FoxhoodDesigns/H-Pulse-Controller/KiCad/TRAIN_MK4.kicad_pcb

## KiCad design KiCad/TRAIN_MK4.kicad_pcb (2025-02-24)

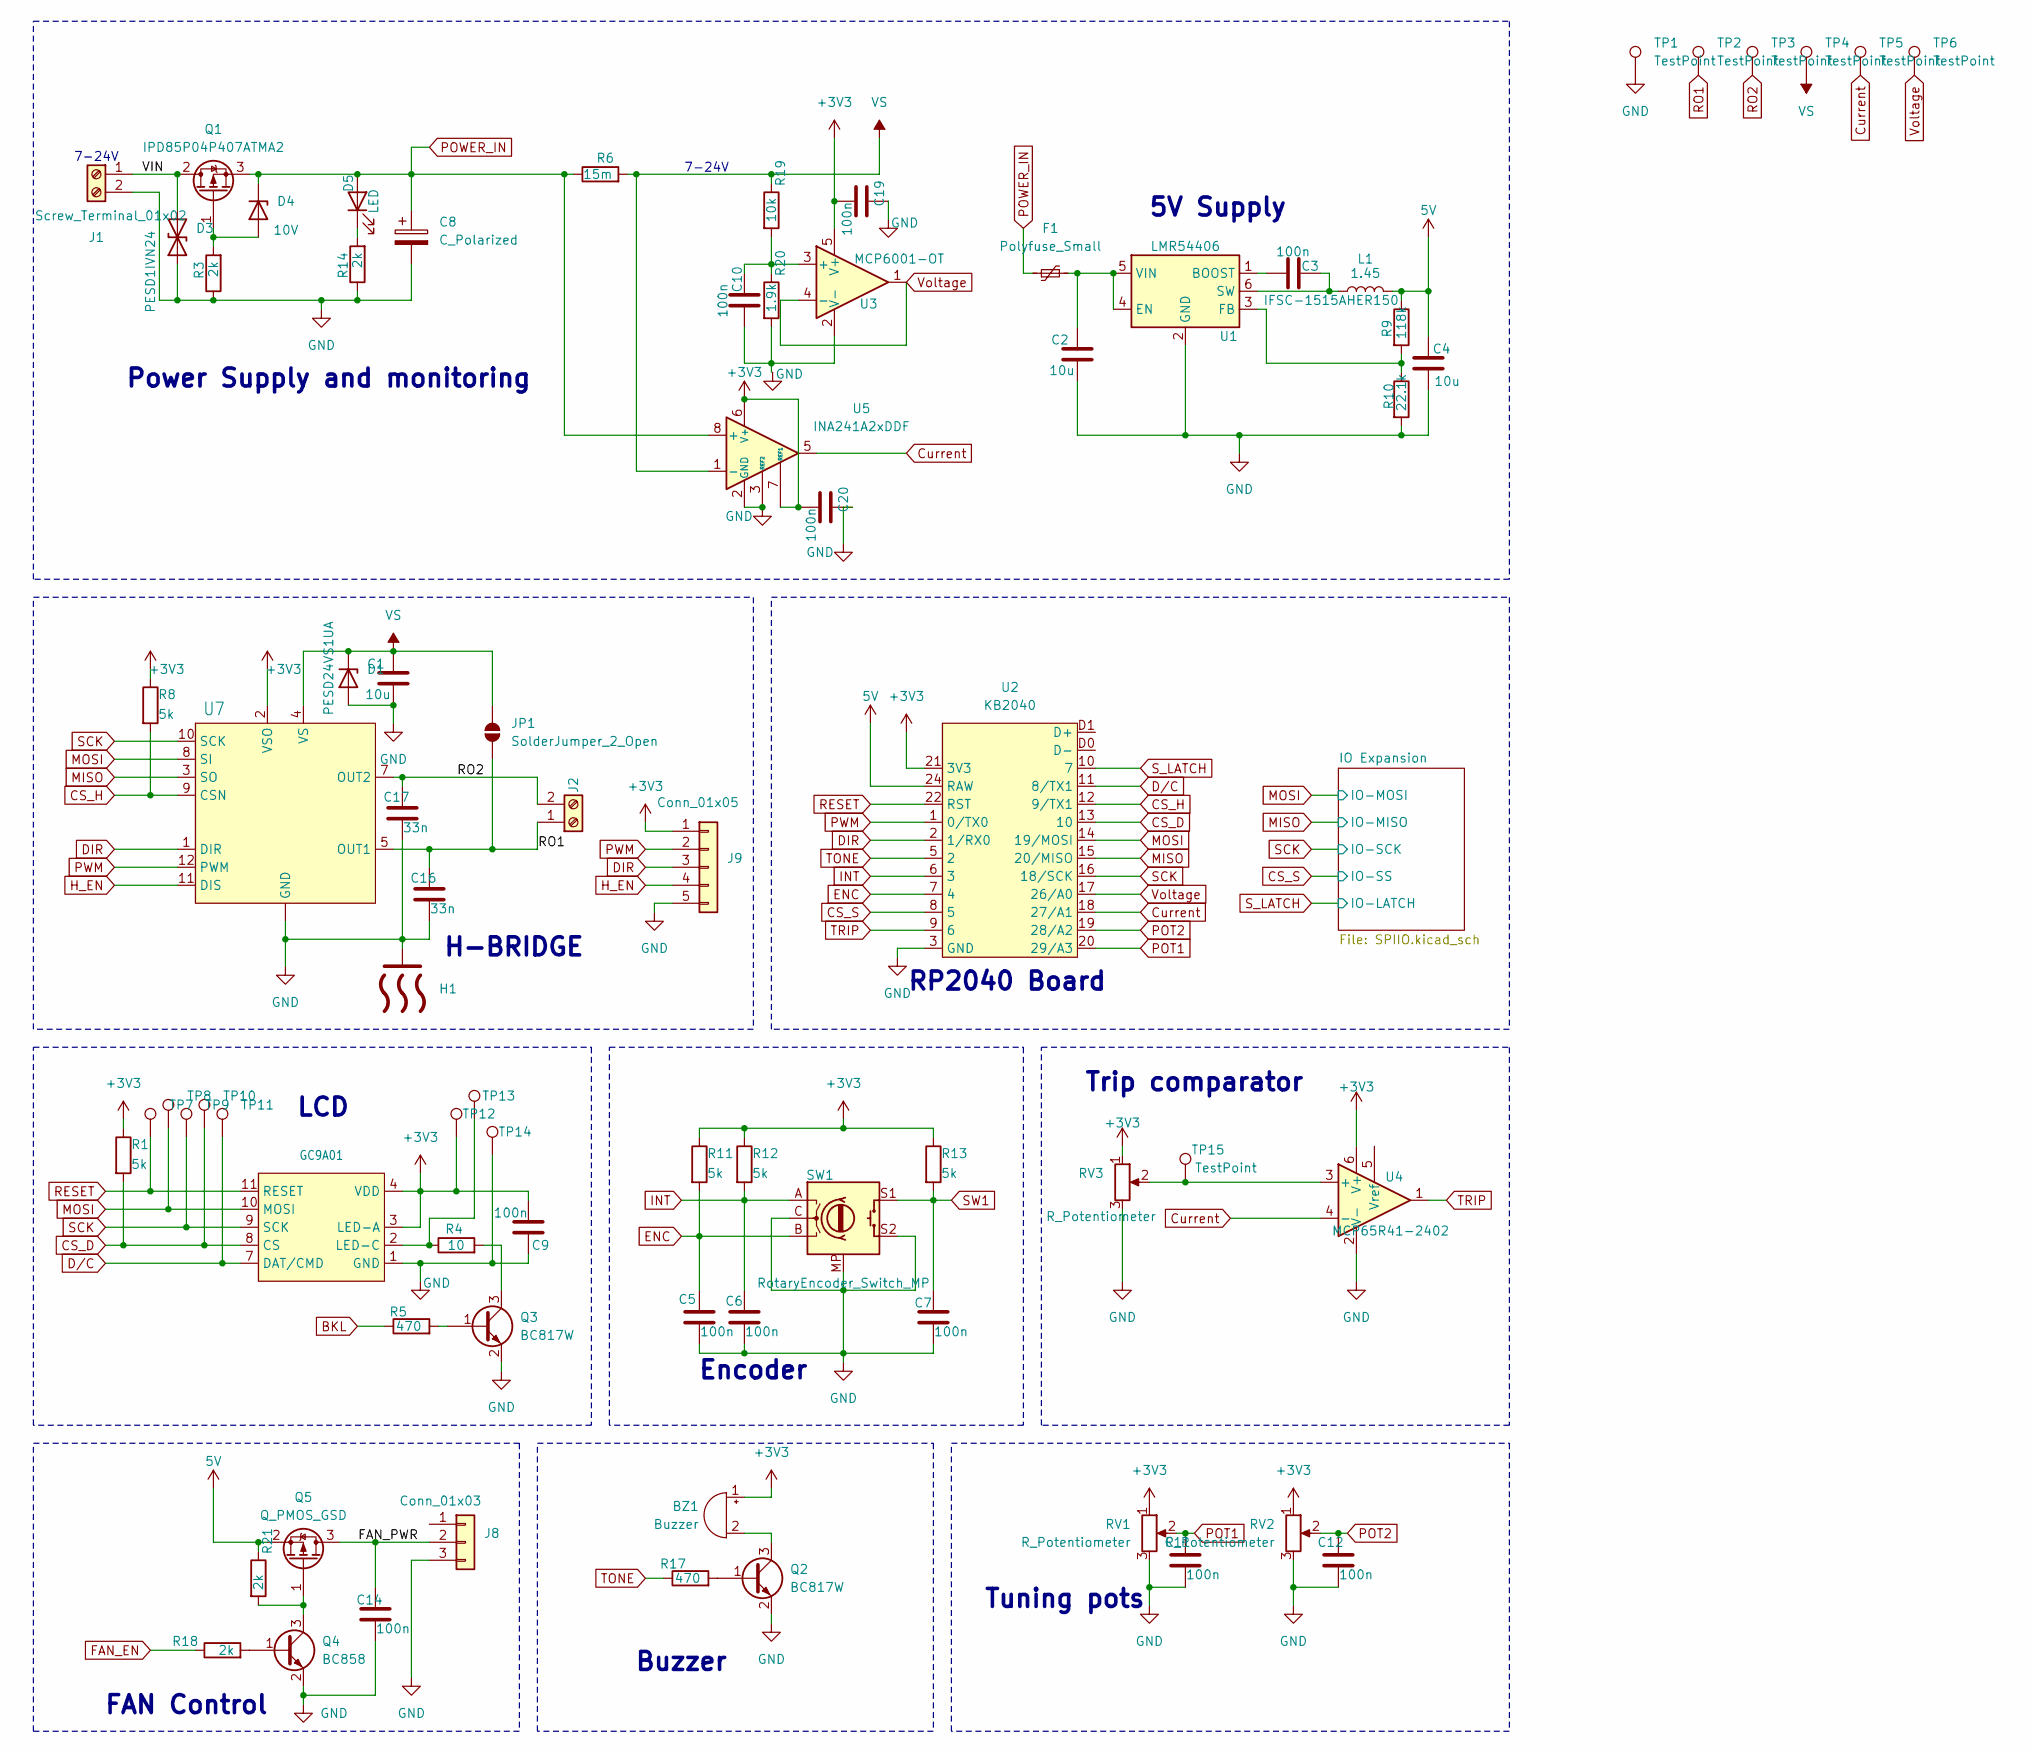
[picture p1: schematic TRAIN_MK4.kicad_sch, H-PULSE Train Controller]

Parts:
BZ1: Buzzer; PUIAudio_SMT_0825_S_4_R
C1, C2, C4: 10u; C_1210_3225Metric_Pad1.33x2.70mm_HandSolder
C3, C5, C6, C7, C9, C10, C11, C12, C14, C19, C20: 100n; C_0805_2012Metric_Pad1.18x1.45mm_HandSolder; Voltage 1kV; Tolerance 100%
C8: C_Polarized; CP_Elec_10x10
C16, C17: 33n; C_0805_2012Metric_Pad1.18x1.45mm_HandSolder; Voltage 1kV; Tolerance 100%
D1: PESD24VS1UA; D_SOD-323_HandSoldering
D3: PESD1IVN24; D_SOD-323_HandSoldering
D4: 10V; Nexperia_CFP3_SOD-123W
D5: LED; LED_0805_2012Metric_Pad1.15x1.40mm_HandSolder
F1: Polyfuse_Small; Fuse_1812_4532Metric_Pad1.30x3.40mm_HandSolder
H1: DPAK-Heatsink
J1, J2: Screw_Terminal_01x02; TerminalBlock_Phoenix_PT-1,5-2-5.0-H_1x02_P5.00mm_Horizontal
J8: Conn_01x03; FanPinHeader_1x03_P2.54mm_Vertical
J9: Conn_01x05; PinHeader_1x05_P2.54mm_Vertical
JP1: SolderJumper_2_Open; SolderJumper-2_P1.3mm_Open_Pad1.0x1.5mm
L1: IFSC-1515AHER150; L_Vishay_IFSC-1515AH_4x4x1.8mm
Q1: IPD85P04P407ATMA2; TO-252-2
Q2, Q3: BC817W; SOT-323_SC-70
Q4: BC858; SOT-323_SC-70_Handsoldering
Q5: Q_PMOS_GSD; SOT-23
R1, R8, R11, R12, R13: 5k; R_0805_2012Metric_Pad1.20x1.40mm_HandSolder
R3, R14, R18, R21: 2k; R_0805_2012Metric_Pad1.20x1.40mm_HandSolder
R4: 10; R_0805_2012Metric_Pad1.20x1.40mm_HandSolder
R5, R17: 470; R_0805_2012Metric_Pad1.20x1.40mm_HandSolder
R6: 15m; R_2010_5025Metric_Pad1.40x2.65mm_HandSolder
R9: 118k; R_0805_2012Metric_Pad1.20x1.40mm_HandSolder
R10: 22.1k; R_0805_2012Metric_Pad1.20x1.40mm_HandSolder
R19: 10k; R_0805_2012Metric_Pad1.20x1.40mm_HandSolder
R20: 1.9k; R_0805_2012Metric_Pad1.20x1.40mm_HandSolder
RV1, RV2: R_Potentiometer; Potentiometer_Vishay_T73YP_Vertical
RV3: R_Potentiometer; Potentiometer_Bourns_3214X_Vertical
SW1: RotaryEncoder_Switch_MP; RotaryEncoder_Bourns_Vertical_PEC12R-3x17F-Sxxxx
TP1, TP2, TP3, TP4, TP5, TP6: TestPoint; TestPoint_Pad_2.0x2.0mm
TP7, TP8, TP9, TP10, TP11, TP12, TP13, TP14: TestPoint; TestPoint_Pad_D1.0mm
TP15: TestPoint; TestPoint_Pad_D2.0mm
U1: LMR54406; TSOT-23-6
U2: KB2040
U3: MCP6001-OT; SOT-23-5
U4: MCP65R41-2402; SOT-23-6
U5: INA241A2xDDF; SOT-23-8
U7: Infineon_PG-DSO-12-17
U8: GC9A01; GC9A01INT

Connections:
5V: C4.1, L1.2, Q5.2 (S), R9.1, R21.1, U2.24 (RAW)
+3V3: BZ1.1 (+), C9.2, C19.2, C20.2, J9.1, R1.1, R8.1, R11.1, R12.1, R13.1, RV1.1, RV2.1, RV3.1, TP12.1, U2.21 (3V3), U3.5 (V+), U4.6 (V+), U5.6 (V+), U5.7 (REF1), U7.2 (VSO), U8.3 (LED-A), U8.4 (VDD); also elsewhere on the board
/FAN_PWR: C14.1, J8.2, Q5.3 (D)
/VIN: D3.2 (A2), J1.1, Q1.2 (D)
BKL: R5.1; also elsewhere on the board
CS_D: R1.2, TP10.1, U2.13 (10), U8.8 (CS)
CS_H: R8.2, U2.12 (9/TX1), U7.9 (CSN)
CS_S: U2.8 (5); also elsewhere on the board
Current: TP5.1, U2.18 (27/A1), U4.4 (-), U5.5
DIR: J9.3, U2.2 (1/RX0), U7.1 (DIR)
D/C: TP11.1, U2.11 (8/TX1), U8.7 (DAT/CMD)
ENC: C5.1, R11.2, SW1.B, U2.7 (4)
FAN_EN: R18.1; also elsewhere on the board
GND: C1.2, C2.2, C4.2, C5.2, C6.2, C7.2, C8.2, C9.1, C11.2, C12.2, C14.2, C16.2, C17.2, C19.1, C20.1, D1.2 (A), D3.1 (A1), H1.1, J1.2, J8.3, J9.5, Q2.2 (E), Q3.2 (E), Q4.2 (E), R3.1, R10.2, R14.1, RV1.3, RV2.3, RV3.3, SW1.C, SW1.MP, SW1.S2, TP1.1, TP14.1, U1.2 (GND), U2.3 (GND), U2.4 (GND), U2.23 (GND), U4.2 (V-), U5.2 (GND), U5.3 (REF2), U5.4 (GND), U7.6 (GND), U7.13 (GND), U8.1 (GND), U8.5 (GND), U8.6 (GND), U8.12 (GND); also elsewhere on the board
H_EN: J9.4, U7.11 (DIS); also elsewhere on the board
INT: C6.1, R12.2, SW1.A, U2.6 (3)
MISO: U2.15 (20/MISO), U7.3 (SO); also elsewhere on the board
MOSI: TP8.1, U2.14 (19/MOSI), U7.8 (SI), U8.10 (MOSI); also elsewhere on the board
unnamed: BZ1.2 (-), Q2.3 (C)
unnamed: D4.2 (A), Q1.1 (G), R3.2
unnamed: D5.1 (K), R14.2
unnamed: Q2.1 (B), R17.2
unnamed: Q3.1 (B), R5.2
unnamed: Q3.3 (C), R4.2
unnamed: Q4.1 (B), R18.2
unnamed: Q4.3 (C), Q5.1 (G), R21.2
unnamed: C3.2, U1.1 (BOOST)
unnamed: C2.1, F1.2, U1.4 (EN), U1.5 (VIN)
unnamed: R9.2, R10.1, U1.3 (FB)
unnamed: C3.1, L1.1, U1.6 (SW)
unnamed: C10.1, R19.2, R20.1, U3.3 (+)
unnamed: C10.2, R20.2, U3.2 (V-)
unnamed: RV3.2, TP15.1, U4.3 (+)
unnamed: R4.1, TP13.1, U8.2 (LED-C)
POT1: C11.1, RV1.2, U2.20 (29/A3)
POT2: C12.1, RV2.2, U2.19 (28/A2)
POWER_IN: C8.1, D4.1 (K), D5.2 (A), F1.1, Q1.3 (S), R6.1, U5.8 (+)
PWM: J9.2, U2.1 (0/TX0), U7.12 (PWM)
RESET: TP7.1, U2.22 (RST), U8.11 (RESET)
RO1: C16.1, J2.1, JP1.1 (A), TP2.1, U7.5 (OUT1)
RO2: C17.1, J2.2, TP3.1, U7.7 (OUT2)
SCK: TP9.1, U2.16 (18/SCK), U7.10 (SCK), U8.9 (SCK); also elsewhere on the board
SW1: C7.1, R13.2, SW1.S1; also elsewhere on the board
S_LATCH: U2.10 (7); also elsewhere on the board
TONE: R17.1, U2.5 (2)
TRIP: U2.9 (6), U4.1
VS: C1.1, D1.1 (K), JP1.2 (B), R6.2, R19.1, TP4.1, U5.1 (-), U7.4 (VS)
Voltage: TP6.1, U2.17 (26/A0), U3.1, U3.4 (-)

Notes on the sheet:
H-BRIDGE
Tuning pots
LCD
7-24V
Buzzer
RP2040 Board
5V Supply
FAN Control
Power Supply and monitoring
Trip comparator
Encoder

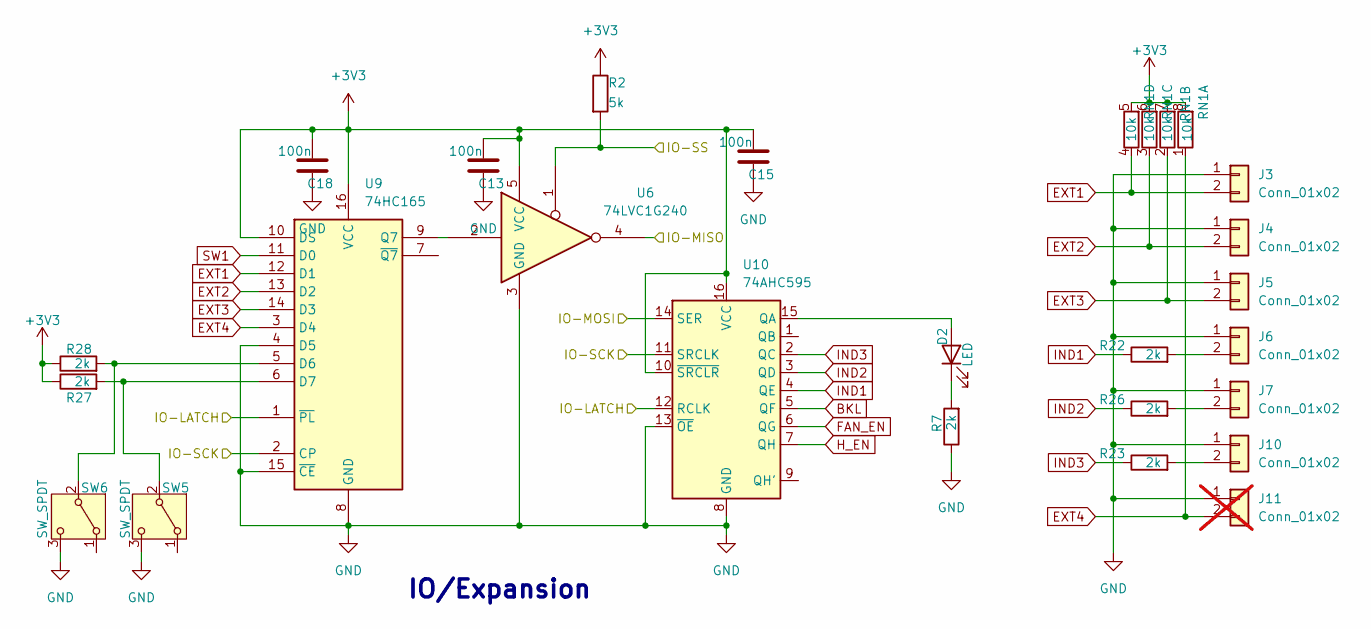
[picture p2: schematic SPIIO.kicad_sch]

Parts:
C13, C15, C18: 100n; C_0805_2012Metric_Pad1.18x1.45mm_HandSolder; Voltage 1kV; Tolerance 100%
D2: LED; LED_0805_2012Metric_Pad1.15x1.40mm_HandSolder
J3, J4, J5, J6, J7, J10: Conn_01x02; JST_XH_B2B-XH-A_1x02_P2.50mm_Vertical
J11: Conn_01x02; PinHeader_1x02_P2.54mm_Vertical_SMD_Pin1Right; not fitted
R2: 5k; R_0805_2012Metric_Pad1.20x1.40mm_HandSolder
R7, R22, R23, R26, R27, R28: 2k; R_0805_2012Metric_Pad1.20x1.40mm_HandSolder
RN1: 10k; R_Array_Convex_4x0603
SW5, SW6: SW_SPDT; SW_Slide_SPDT_Straight_CK_OS102011MS2Q
U6: 74LVC1G240; SOT-23-5_HandSoldering
U9: 74HC165; TSSOP-16_4.4x5mm_P0.65mm
U10: 74AHC595; TSSOP-16_4.4x5mm_P0.65mm

Connections:
+3V3: C13.2, C15.2, C18.2, R2.1, R27.1, R28.1, RN1.5 (R4.2), RN1.6 (R3.2), RN1.7 (R2.2), RN1.8 (R1.2), U6.5 (VCC), U9.10 (DS), U9.16 (VCC), U10.10 (~SRCLR), U10.16 (VCC); also elsewhere on the board
BKL: U10.5 (QF); also elsewhere on the board
CS_S: R2.2, U6.1; also elsewhere on the board
EXT1: J3.2, RN1.4 (R4.1), U9.12 (D1)
EXT2: J4.2, RN1.3 (R3.1), U9.13 (D2)
EXT3: J5.2, RN1.2 (R2.1), U9.14 (D3)
EXT4: J11.2, RN1.1 (R1.1), U9.3 (D4)
FAN_EN: U10.6 (QG); also elsewhere on the board
GND: C13.1, C15.1, C18.1, J3.1, J4.1, J5.1, J6.1, J7.1, J10.1, J11.1, R7.1, SW5.3 (C), SW6.3 (C), U6.3 (GND), U9.4 (D5), U9.8 (GND), U9.15 (~CE), U10.8 (GND), U10.13 (~OE); also elsewhere on the board
H_EN: U10.7 (QH); also elsewhere on the board
IND1: R22.1, U10.4 (QE)
IND2: R26.1, U10.3 (QD)
IND3: R23.1, U10.2 (QC)
MISO: U6.4; also elsewhere on the board
MOSI: U10.14 (SER); also elsewhere on the board
unnamed: D2.2 (A), U10.15 (QA)
unnamed: D2.1 (K), R7.2
unnamed: J6.2, R22.2
unnamed: J7.2, R26.2
unnamed: J10.2, R23.2
unnamed: R27.2, SW5.2 (B), U9.6 (D7)
unnamed: R28.2, SW6.2 (B), U9.5 (D6)
unnamed: U6.2, U9.9 (Q7)
SCK: U9.2 (CP), U10.11 (SRCLK); also elsewhere on the board
SW1: U9.11 (D0); also elsewhere on the board
S_LATCH: U9.1 (~PL), U10.12 (RCLK); also elsewhere on the board

Notes on the sheet:
IO/Expansion

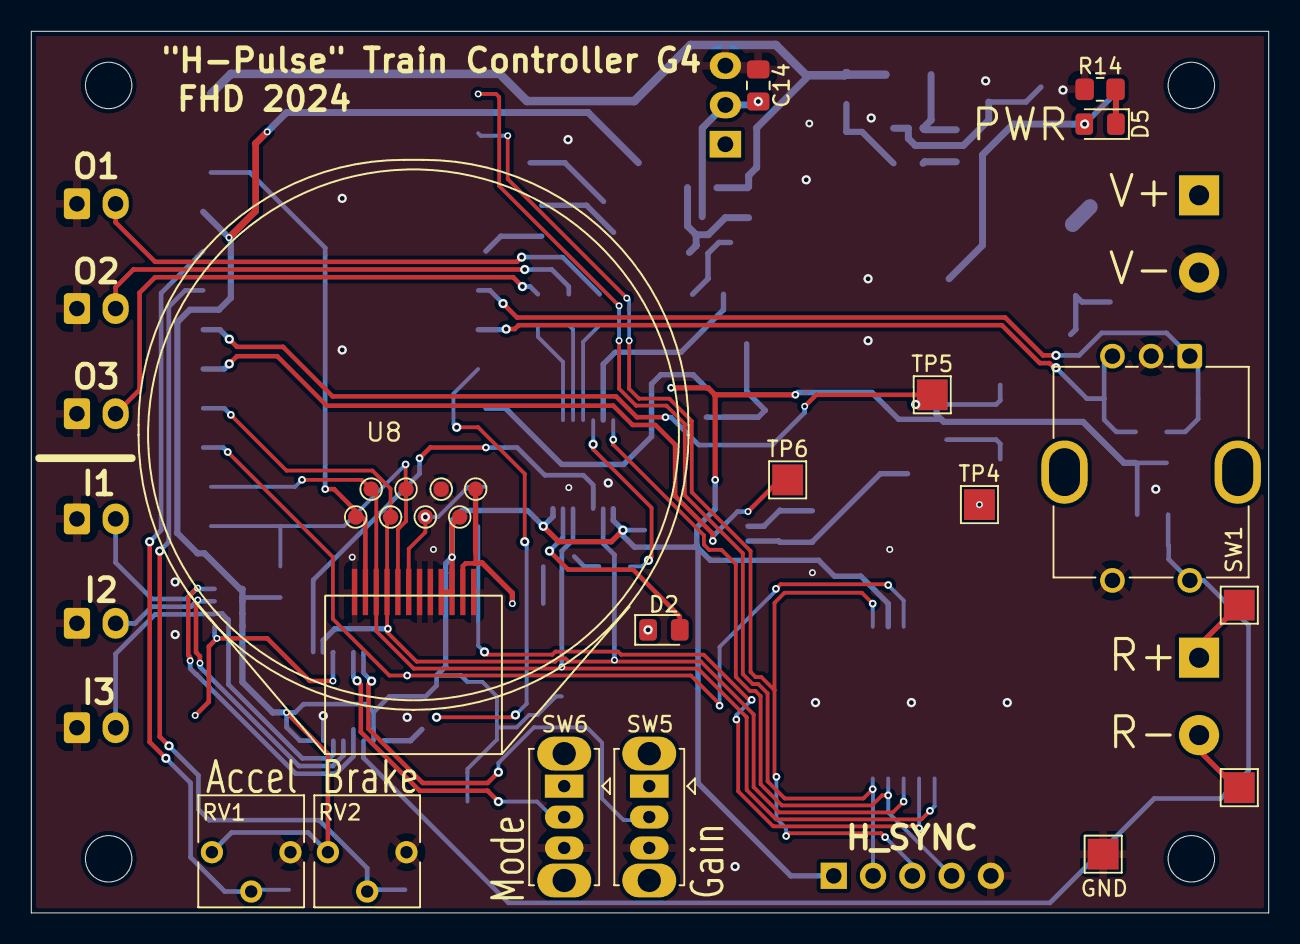
[picture p3: board TRAIN_MK4.kicad_pcb from above]

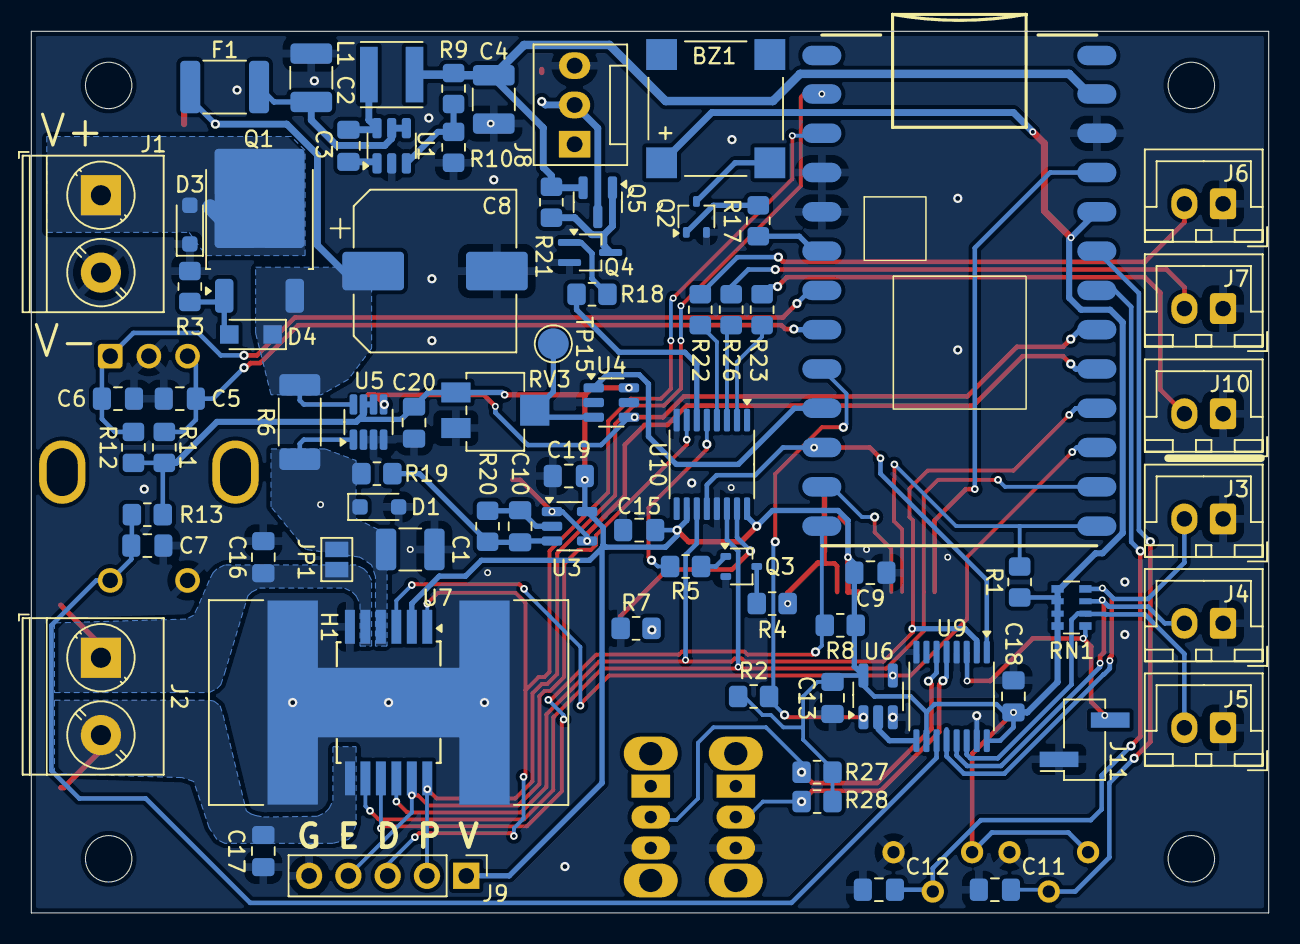
[picture p4: board TRAIN_MK4.kicad_pcb from below]

Board: 2 copper layers, 80.0 x 57.0 mm, 102 parts (78 on the bottom side), 63 nets.
