FoxhoodDesigns/H-Pulse-Controller/(commit log)

2025-02-23 Initial Upload
    Initial Upload of Schematic and PCB
    [TRAIN_MK4.csv, TRAIN_MK4.kicad_pcb, TRAIN_MK4.kicad_sch]
2025-02-24 Update
    Dividing schematic part 1
    [SPIIO.kicad_sch, TRAIN_MK4.kicad_pcb, TRAIN_MK4.kicad_sch]
2025-02-24 Update
    Documentation related changes and small DRU corrections
    [SPIIO.kicad_sch, TRAIN_MK4.kicad_pcb, TRAIN_MK4.kicad_sch]
